XE1E/Perpetual-Calendar-with-Google-Calendar-Connection-V2/docs/images/gcal/README.md

# Capturas de Pantalla — Guía de Google Calendar

Esta carpeta contiene las capturas usadas en la [Guía de Configuración de Google Calendar](../../../GOOGLE_CALENDAR_SETUP.md).

Las guías (ES y EN) incluyen **marcadores** (líneas que empiezan con 📷) donde irá cada imagen. Para activarla:

1. Captura la pantalla indicada.
2. Guárdala en esta carpeta con el nombre sugerido.
3. En la guía, cambia la línea del marcador por:
   `![descripción](docs/images/gcal/nombre.png)` (en ambos archivos, `.md` y `.en.md`).

## Lista de capturas pendientes

| Archivo | Qué capturar |
|---|---|
| `01-crear-calendario.png` | Diálogo "Crear calendario" de Google Calendar |
| `02-id-calendario.png` | Sección "Integrar el calendario" con el ID del calendario |
| `03-editor-script.png` | Editor de Apps Script con el código pegado |
| `04-nueva-implementacion.png` | Diálogo "Nueva implementación" (tipo "Aplicación web" + permisos) |
| `05-autorizar.png` | Pantalla "Google no ha verificado esta aplicación" con el enlace "Avanzado" |
| `06-id-implementacion.png` | Diálogo final mostrando el "ID de implementación" |
| `07-config-dispositivo.png` | Página `appsscript.html` del dispositivo con los 3 IDs pegados |

> 💡 Recomendado: PNG, ancho ~800–1000 px, recortadas al área relevante. Oculta datos sensibles (IDs reales, correo) si las vas a publicar.
