XE1E/Perpetual-Calendar-with-Google-Calendar-Connection-V2/docs/images/acrilico_ahumado.jpg

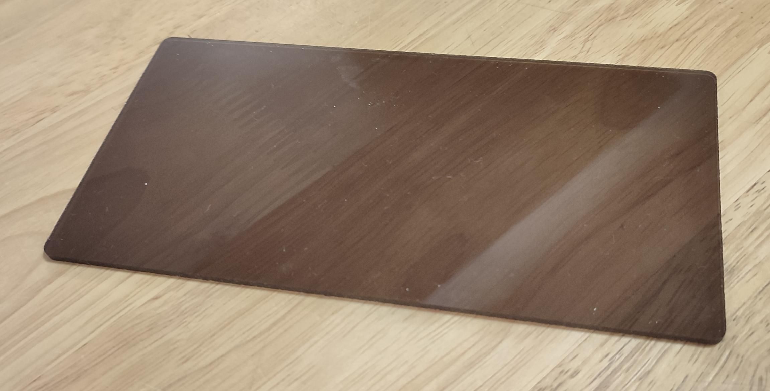
docs/images/acrilico_ahumado.jpg
