XE1E/Perpetual-Calendar-with-Google-Calendar-Connection-V2/docs/images/enero_domingo.png

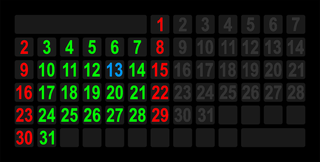
docs/images/enero_domingo.png
