XE1E/Perpetual-Calendar-with-Google-Calendar-Connection-V2/docs/images/marco_3d_frame.jpg

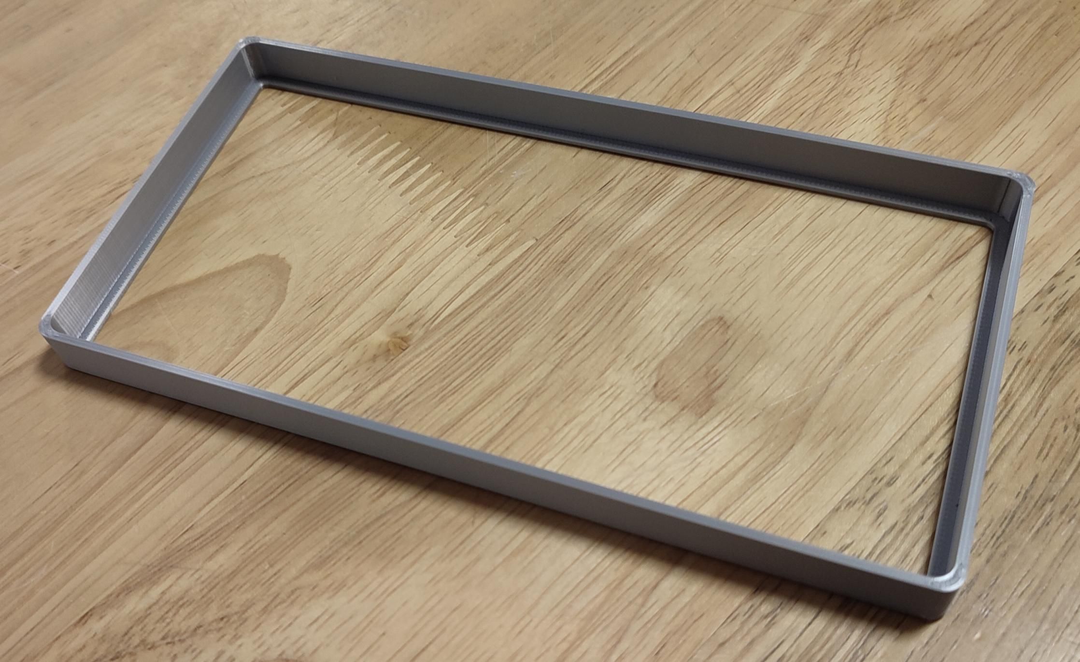
docs/images/marco_3d_frame.jpg
