XE1E/Perpetual-Calendar-with-Google-Calendar-Connection-V2/docs/images/pata_soporte.jpg

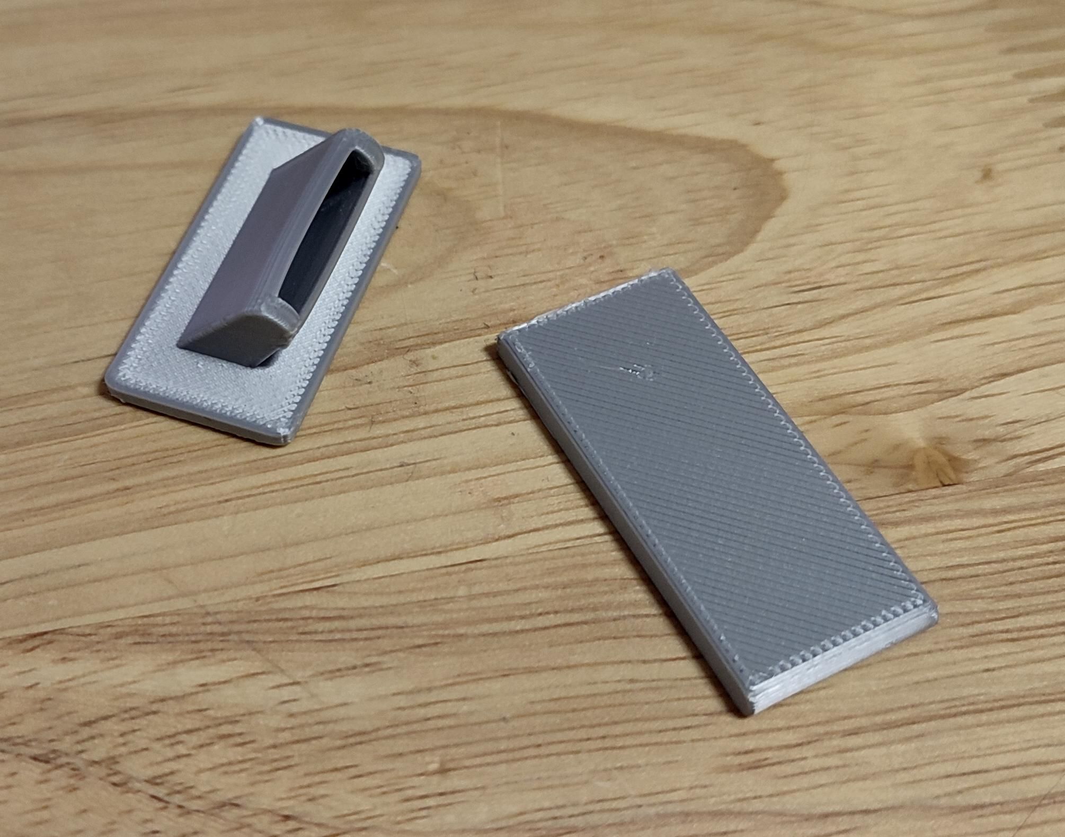
docs/images/pata_soporte.jpg
