XE1E/Perpetual-Calendar-with-Google-Calendar-Connection-V2/docs/images/rejilla_3d.jpg

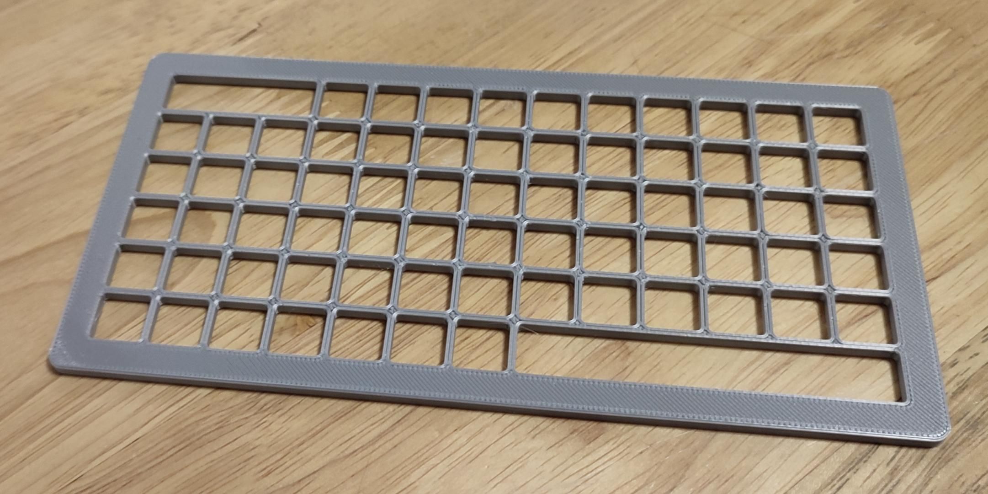
docs/images/rejilla_3d.jpg
