XE1E/Perpetual-Calendar-with-Google-Calendar-Connection-V2/docs/images/soporte_leds_3d.jpg

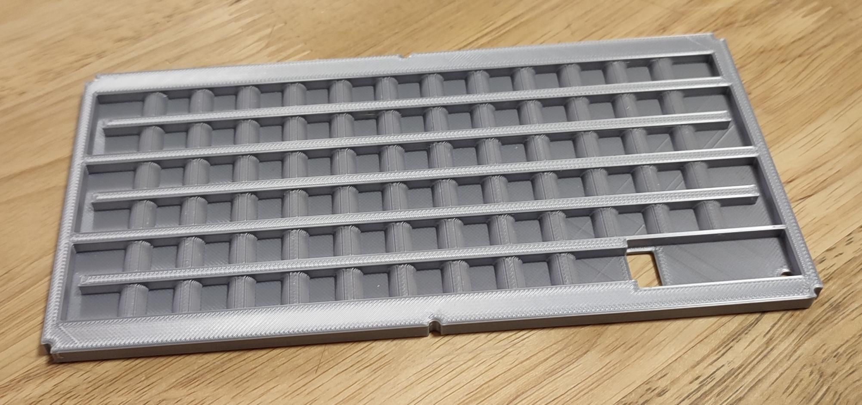
docs/images/soporte_leds_3d.jpg
