XE1E/Perpetual-Calendar-with-Google-Calendar-Connection-V2/docs/plantilla_numeros.pdf

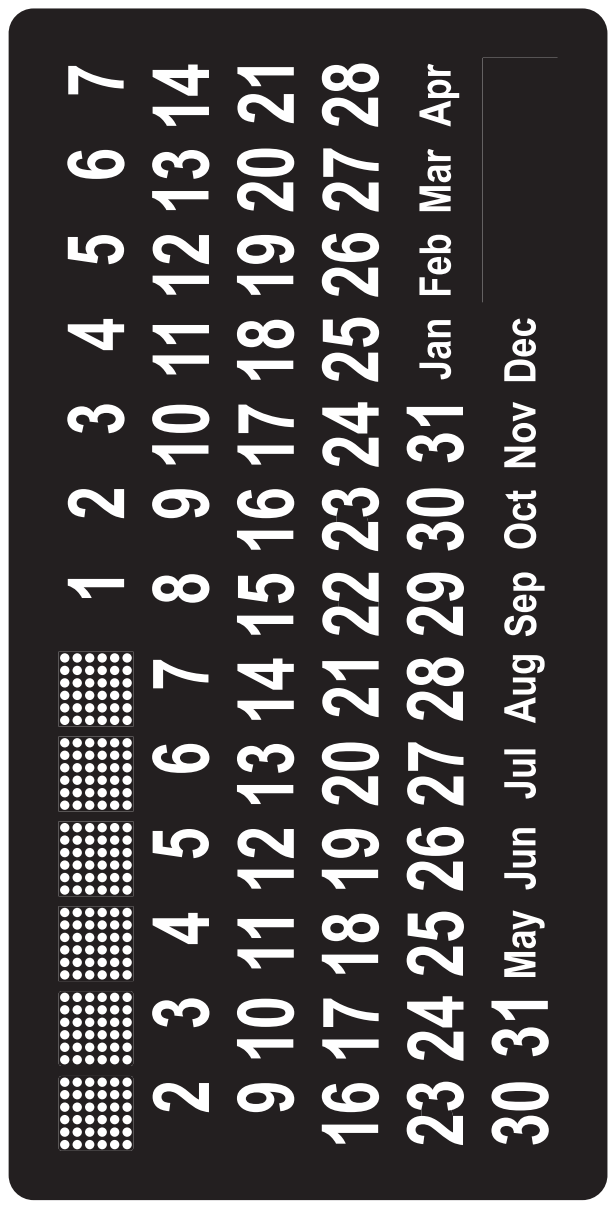
[picture p12: page 1]
