XE1E/Perpetual-Calendar-with-Google-Calendar-Connection-V2/Page_LEDSettings.h

#ifndef PAGE_LEDSETTINGS_H
#define PAGE_LEDSETTINGS_H

const char PAGE_LEDSettings[] PROGMEM = R"=====(
<meta name="viewport" content="width=device-width, initial-scale=1" />
<body>
<div style="display:flex;justify-content:space-between;align-items:center">
<strong data-i18n="led_settings">Configuracion LEDs</strong>
<button id="langBtn" onclick="toggleLang()" class="btn btn--s btn--blue">EN</button>
</div>
<hr>
<form action="">
<table style="width:310px">
<tr><td style="width:150px" data-i18n="brightness">Brillo:</td><td><input type="range" id="brightness" name="brightness" min="5" max="255" value="100" oninput="updateBrightness(this.value)"><span id="brightnessVal">100</span></td></tr>
<tr><td colspan="2" style="padding-top:10px"><input type="button" id="saveBtn" style="width:150px" class="btn btn--m btn--grey" value="Save" onclick="saveBrightness()"></td></tr>
</table>
</form>
<hr>
<strong data-i18n="preview">Vista Previa</strong>
<table style="width:310px">
<tr><td><input type="button" id="testBtn" style="width:130px" class="btn btn--s btn--grey" value="Probar LEDs" onclick="testLeds()"></td>
<td><input type="button" id="refreshBtn" style="width:130px;height:50px;white-space:normal" class="btn btn--s btn--grey" value="Actualizar Calendario" onclick="refreshCalendar()"></td></tr>
</table>
<hr>
<a href="/" style="width:250px" class="btn btn--m btn--grey"><span data-i18n="back">Volver</span></a>
</body>
<script>
window.onload = function() {
    load("style.css","css", function() {
        load("microajax.js","js", function() {
            initLang();
            updateBtnLabels();
            loadBrightness();
        });
    });
}
function updateBtnLabels() {
    document.getElementById("saveBtn").value = t("save");
    document.getElementById("testBtn").value = t("test_leds");
    document.getElementById("refreshBtn").value = t("refresh");
}
function load(e,t,n){if("js"==t){var a=document.createElement("script");a.src=e,a.type="text/javascript",a.async=!1,a.onload=function(){n()},document.getElementsByTagName("head")[0].appendChild(a)}else if("css"==t){var a=document.createElement("link");a.href=e,a.rel="stylesheet",a.type="text/css",a.async=!1,a.onload=function(){n()},document.getElementsByTagName("head")[0].appendChild(a)}}

function loadBrightness() {
    microAjax("/admin/ledvalues", function(res) {
        var data = JSON.parse(res);
        document.getElementById("brightness").value = data.brightness;
        document.getElementById("brightnessVal").innerHTML = data.brightness;
    });
}

function updateBrightness(val) {
    document.getElementById("brightnessVal").innerHTML = val;
    microAjax("/admin/setbrightness?val=" + val, function(res) {});
}

function saveBrightness() {
    var val = document.getElementById("brightness").value;
    microAjax("/admin/savebrightness?val=" + val, function(res) {
        alert("Brightness saved!");
    });
}

function testLeds() {
    microAjax("/admin/testleds", function(res) {});
}

function refreshCalendar() {
    microAjax("/admin/refreshcalendar", function(res) {});
}
</script>
)=====";

void send_LED_Settings_html() {
    server.send_P(200, "text/html", PAGE_LEDSettings);
}

void send_LED_Settings_values_html() {
    String response = "{\"brightness\":\"" + String(BRIGHTNESS) + "\"}";
    server.send(200, "application/json", response);
}

void handle_set_brightness() {
    if (server.hasArg("val")) {
        BRIGHTNESS = server.arg("val").toInt();
        if (BRIGHTNESS < 5) BRIGHTNESS = 5;
        if (BRIGHTNESS > 255) BRIGHTNESS = 255;
        FastLED.setBrightness(BRIGHTNESS);
        FastLED.show();
    }
    server.send(200, "text/plain", "OK");
}

void handle_save_brightness() {
    if (server.hasArg("val")) {
        BRIGHTNESS = server.arg("val").toInt();
        if (BRIGHTNESS < 5) BRIGHTNESS = 5;
        if (BRIGHTNESS > 255) BRIGHTNESS = 255;
        EEPROM.write(488, BRIGHTNESS);
        EEPROM.commit();
        FastLED.setBrightness(BRIGHTNESS);
        FastLED.show();
    }
    server.send(200, "text/plain", "OK");
}

// Flag para test de LEDs (procesado en loop principal)
volatile bool testLedsRequested = false;

void handle_test_leds() {
    testLedsRequested = true;
    server.send(200, "text/plain", "OK");
}

// Llamar desde loop() principal
void processTestLeds() {
    if (!testLedsRequested) return;
    testLedsRequested = false;

    uint8_t originalBrightness = FastLED.getBrightness();
    FastLED.setBrightness(60);

    // 3 parpadeos
    for (int p = 0; p < 3; p++) {
        fill_solid(leds, NUM_LEDS, CRGB::White);
        FastLED.show();
        FastLED.delay(150);

        fill_solid(leds, NUM_LEDS, CRGB::Black);
        FastLED.show();
        FastLED.delay(100);
    }

    FastLED.setBrightness(originalBrightness);
    temp_minute = -1;
}

void handle_refresh_calendar() {
    temp_hour = -1;
    temp_minute = -1;
    server.send(200, "text/plain", "OK");
}

#endif
