XE1E/Perpetual-Calendar-with-Google-Calendar-Connection-V2/(commit log)

2026-04-21 Add comprehensive Spanish manual documentation
    Complete technical documentation covering hardware, software architecture,
    LED mapping, NTP sync, Google Calendar integration, and troubleshooting.
2026-04-21 Add mDNS, OTA updates, and LED brightness control
    - mDNS: Access device via http://perpetualcalendar.local
    - OTA: Over-the-air firmware updates with LED progress indicator
    - LED Settings: Web-based brightness control (10-255) with EEPROM persistence
    - New pages: /led.html and /ota.html
    - Test LEDs and refresh calendar buttons
2026-04-21 Fix color coded clock display issues
    - Move clock LEDs to 63-67 to avoid conflict with warning_led (62)
    - Add blinking separator LED for seconds indication
    - Use non-blocking updateClockIfNeeded() with millis() tracking
    - Add yield() between HTTP calls to reduce blocking
    - Refresh clock after calendar updates to prevent overwrite
    - Optimize FastLED.show() calls with needsRefresh flag
    [ColorCodedClock.h]
2026-06-16 Restore HH:MM:SS clock display with immediate updates
    - Change clock to 6 LEDs (62-67) showing hours, minutes, seconds
    - Add immediate FastLED.show() on clock updates for smooth seconds
    - Add clock refresh calls between blocking getCalendar() HTTP requests
    - WiFi warning now blinks clock LEDs red instead of using separate LED
2026-06-16 Lower minimum brightness to 5 for better night mode
    - Change slider min from 10 to 5 in LED Settings and Auto Brightness pages
    - Update validation in brightness handlers to allow values down to 5
    - Update EEPROM read validation to accept brightness >= 5
2026-06-16 Add option to turn off LEDs at night (brightness = 0)
    - Allow night brightness slider to go to 0 (OFF)
    - Show "OFF" label when night brightness is 0
    - FastLED.setBrightness(0) turns off all LEDs completely
2026-06-16 Update Spanish manual with clock and brightness changes
    - Clock now shows HH:MM:SS (6 LEDs: 62-67) instead of HH:MM + separator
    - WiFi warning now blinks clock LEDs red (no separate LED)
    - Minimum brightness reduced to 5
    - Night brightness can be set to 0 (OFF) for complete darkness
    - Updated specs table and examples
2026-06-16 @ Add bilingual web interface (ES/EN) and standardize UI
    - Add complete i18n translation system with localStorage persistence
    - Spanish as default language with EN toggle button on all pages
    - Replace triangle back buttons with "Volver" button across all pages
    - Widen LED settings button frames for better text fit
    - Set default NTP server to time.cloudflare.com
    - Update English README documentation
    @
    [Page_Admin.h, Page_AppsScriptSettings.h, Page_AutoBrightness.h, Page_ColorSettings.h, Page_Information.h, Page_LEDSettings.h, Page_NTPSettings.h, Page_NetworkConfiguration.h]
2026-06-16 @ Add current month color and gamma correction settings
    - Add customizable color for current month indicator
    - Add gamma correction settings in Color Settings page:
    - Color profile: None/TypicalLEDStrip/TypicalSMD5050
    - Temperature: None/DirectSunlight/Tungsten100W/ClearBlueSky
    - Settings persist in EEPROM and apply on startup
    - Update bilingual translations for new UI elements
    - Update documentation with new features
    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
    [Page_ColorSettings.h, Page_Script.js.h, Perpetual-Calendar-With-Google-Calendar-Connection-V2.ino]
2026-06-17 Fix NTP interval bug, improve LED test, add Spanish web UI
    - Fix NTP interval always resetting to 30 on sync (remove hardcoded override)
    - LED test now uses brightness 128 temporarily for visibility
    - Web flasher page now bilingual (ES default, EN toggle)
    - Update color clock info: HH:MM:SS on LEDs 62-67
    - Update compiled firmware binaries
    [Page_LEDSettings.h]
2026-06-17 Code optimization and bug fixes for ESP8266
    Optimizations:
    - Remove duplicate tkSecond.attach() call in setup()
    - Remove duplicate monthDays array in NTP.h (-12 bytes RAM)
    - Fix HTTPSRedirect memory leak (delete client before new)
    - Add WiFi connection timeout (20s) to prevent infinite block
    - Use proper types: bool, uint8_t, uint16_t where appropriate
    - Remove unused variables in NTP.h
    - Add parentheses in logical expressions (fix warnings)
    Bug fixes:
    - Fix NTP interval resetting to 30 on each sync (from earlier)
    - Disable LED test feature (timing conflicts with ESP8266/WiFi)
    Code quality:
    - Zero compiler warnings
    - Cleaner type usage throughout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
    [Page_LEDSettings.h, Perpetual-Calendar-With-Google-Calendar-Connection-V2.ino, global.h]
2026-06-18 WIP: Simplified working version - calendar and Google events functional
    Fixed issues:
    - customWatchdog reset in loop (prevents 30s reboot)
    - Removed connectToGoogle() from setup (connect on demand)
    - Re-initialize FastLED after Google connections
    - Fixed brightness at 150
    Working features:
    - Calendar display with correct day positions
    - Google Calendar events (Holidays, Anniversaries, Todos)
    - mDNS at perpetualcalendar.local
    - Simple config page for first day of week
    TODO: Integrate full web interface (Page_Admin.h, etc.)
    [Page_LEDSettings.h, Page_Script.js.h, Perpetual-Calendar-With-Google-Calendar-Connection-V2.ino, global.h]
2026-06-18 @ Integrate full web interface with all configuration pages
    - Add complete web interface with all Page_*.h handlers
    - LED settings with live brightness control
    - Auto brightness with day/night scheduling
    - Custom color settings with HSV picker
    - Gamma correction and color temperature
    - Network, NTP, Apps Script configuration pages
    - OTA update support
    - Maintain watchdog and FastLED reinit fixes
    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
    [AutoBrightness.h, Page_ColorSettings.h, Perpetual-Calendar-With-Google-Calendar-Connection-V2.ino]
2026-06-19 @ Fix color settings page to properly save and display custom colors
    - Replace microAjax with XMLHttpRequest for reliable API calls
    - Always load colors from EEPROM into customColors struct for UI display
    - Fix enabled flag comparison (enabledByte == 1)
    - Add EEPROM validation for uninitialized values (h==255 && s==255)
    - Fix handle_reset_colors to update struct before saving
    - Remove temp_hour reset from color handlers to avoid unnecessary Google Calendar reload
    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
    [Page_ColorSettings.h]
2026-06-19 Add system info page with resources, restart and clear WiFi buttons
    - Add information page showing RAM, Flash, CPU, Uptime
    - Add restart ESP button with confirmation
    - Add clear WiFi button to reset network credentials
    - Improve color settings persistence and UI (bigger buttons)
    - Set animation brightness to 120
    - Update documentation to v2.1
    [Page_Admin.h, Page_ColorSettings.h, Page_Information.h, Page_Script.js.h, Perpetual-Calendar-With-Google-Calendar-Connection-V2.ino]
2026-06-19 Update compiled firmware binaries with latest code changes
    Includes: system info page, restart button, clear WiFi button,
    improved color settings, animation brightness 120
2026-06-19 Fix LED test function and improve button labels
    - Fix test LEDs using flag-based approach (runs from main loop)
    - Rename refresh button to "Actualizar Calendario" with two-line text
    - Update translations for refresh button
    [Page_LEDSettings.h, Page_Script.js.h, Perpetual-Calendar-With-Google-Calendar-Connection-V2.ino]
2026-06-19 Add Spanish translation with language toggle
    - Set Spanish as default language
    - Add ES/EN toggle switch in header
    - Store language preference in localStorage
    - Responsive toggle positioning for mobile
2026-06-19 Fix conditional compilation for color coded clock
    - Wrap ColorCodedClock.h include with #ifdef COLOR_CODED_CLOCK
    - Wrap refreshClock call with #ifdef COLOR_CODED_CLOCK
    - Now standard and color_coded_clock builds are properly different
    [Perpetual-Calendar-With-Google-Calendar-Connection-V2.ino]
2026-06-19 Add complete build guide with images and fix outdated documentation
    - Add GUIA_COMPLETA.html with full build instructions in Spanish
    - Add 12 images from original Instructables guide
    - Add plantilla_numeros.pdf for printing number template
    - Fix clock LED references: now uses LEDs 62-67 for HH:MM:SS (not 63-66)
    - Fix WiFi AP credentials: SSID "Calendario", password "12345678"
    - Update Web Flasher page with correct AP info and clock description
2026-06-20 Update documentation to match firmware v2.2
    MANUAL.md:
    - Fix EEPROM map: auto-brightness uses 489-495, colors use 584-607
    - Update Color Coded Clock activation (now separate firmware builds)
    - Fix rainbow colors HSV values to match code
    - Update default brightness to 150
    - Add gamma correction documentation
    - Remove incorrect LED 62 WiFi indicator reference
    - Recommend time.cloudflare.com for NTP server
    GUIA_COMPLETA.html:
    - Make all links clickable (Web Flasher, PDF, GitHub, Tinkercad)
    - Update NTP server to time.cloudflare.com
    - Update page names to match actual web interface
    - Expand web interface section with complete documentation for all 10 pages
    - Update Google Apps Script to work wi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
2026-06-21 Add STL file for direct download from documentation
    Users can now download the 3D model directly from the build guide
    instead of having to visit Tinkercad. Added download links in both
    GUIA_COMPLETA.html and index.html.
2026-06-22 docs: expand and add bilingual documentation
    Add new docs:
    - BILL_OF_MATERIALS (ES/EN): components, 3D parts, tools
    - ASSEMBLY (ES/EN): wiring + step-by-step build
    - QUICK_REFERENCE (ES/EN): pinout, colors, endpoints cheat sheet
    - TROUBLESHOOTING (ES/EN): consolidated issue reference
    - CHANGELOG: firmware version history (v1.0-v2.2)
    - CONTRIBUTING: bilingual contribution guide
    - MANUAL.en, GOOGLE_CALENDAR_SETUP.en: English translations
    Updates:
    - README (ES): align features with EN (clock, night mode, info panel)
    - READMEs: link all new docs, point EN README to .en versions
    - docs/index.html: add bilingual post-install setup section
    - GOOGLE_CALENDAR_SETUP (ES/EN): add screenshot markers +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
2026-10-08 Docs: calendars reload hourly, not every minute
    The firmware loads Holidays, Anniversaries and Todos once per hour
    (temp_hour != DateTime.hour), plus on boot and when color or LED settings
    are saved (temp_hour = -1). The manuals and setup guides said Todos refreshed
    every minute and told users to wait 1-2 minutes; they now explain how to force
    a reload (restart or save the colors page).
